wjcyun/Real-time-interactive-platform/Hardware_configuration.pdf

Table. S1 Hardware list

Hardware Module
Item(model) | Image | Parameter | Link
Computer | | Precision 5820 Tower Inter(R) Xeon(R) W-2155 CPU NVIDIA GeForce RTX 2080Ti | https://www.dell.com/zh-cn/shop/ (https://www.dell.com/zh-cn/shop/)

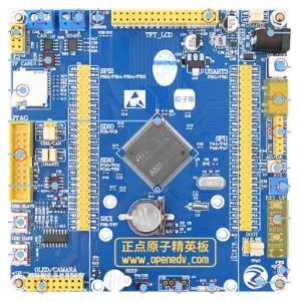
[picture p1: figure]

Stm32 | | STM32F103ZET6 72 MHz clock | https://item.taobao.com/item.htm?spm=a1z 0k.7386009.1997985 097.d4918993.46cf3 7de6uNgrP&id=5230 92580242&_u=t2dm g8j26111
Camera | | HF868SS Pixel Size 3um*3um 480P:120 fps | https://detail.tmall.com/item.htm?_u=t2dmg8j26111&id=627225947424&spm=a1z0 k.7386009.19979850 97.d4918993.46cf37 de6uNgrP

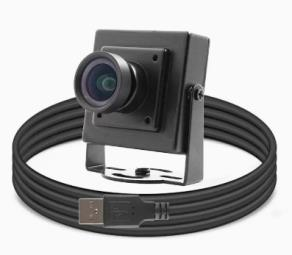
[picture p2: figure]

Servo Motor Driver | | 0.1kw-5.5kw SVPWM 220VAC+10% ~-15% RS-485 | http://www.fereme.cn.tonbao.com/
Slide rail | | Length: 1000 mm Width: 1000 mm | https://item.taobao.com/item.htm?spm=a1z 0k.7386009.1997985 097.d4918993.46cf3 7de6uNgrP&id=6291 15224689&_u=t2dm g8j26111
Square Magnetic Block | | Length: 100 mm Width: 50 mm Thickness: 20 mm | https://item.taobao.com/item.htm?spm=a1z 0k.7386009.1997985 097.d4918993.46cf3 7de6uNgrP&id=5840 42996591&_u=t2dm g8j26111

Round magnetic block | Diameter 40 mm thickness 10 mm | https://detail.tmall.com/item.htm?id=6198 64317122
Regulated power supply | Output voltage: 0-30 V Output current: 0-3 A | https://item.taobao.com/item.htm?spm=a1z 0k.7386009.1997985 097.d4918993.46cf3 7de6uNgrP&id=6104 65415897&_u=t2dm g8j26111

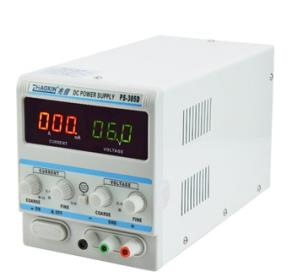
[picture p3: figure]

circuit board | Length: 60 mm Width: 40 mm Hole spacing: 2.54 mm | https://detail.tmall.com/item.htm?abbucket=0&id=619035415749&ns=1&skuId=4368959501684&spm=a 21n57.1.0.0.7237523 chCxvsC
Square acrylic plate | Length: 800 mm Width: 800 mm Thickness：10 mm | https://detail.tmall.com/item.htm?_u=t2dmg8j26111&id=45653259177&spm=a1z0k. 7386009.1997985097 .d4918993.46cf37de6 uNgrP

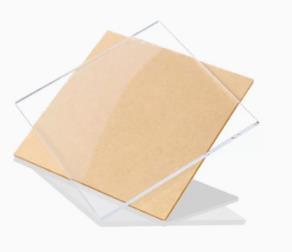
[picture p4: figure]
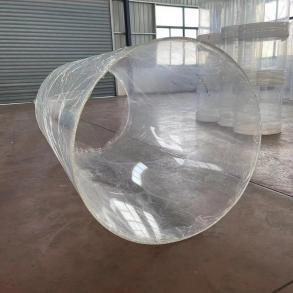
[picture p5: figure]

Acrylic cylinder | Diameter 800 mm, height 300 mm, thickness 8 mm | https://item.taobao.com/item.htm?spm=a1z 0k.7386009.0.0.46cf 37de6uNgrP&id=668 894324208&_u=t2d mg8j26111

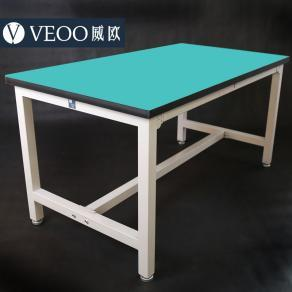
[picture p6: figure]

Anti-vibration table | Length 1500 mm Width 1500 mm Height 750 mm | https://item.taobao.com/item.htm?spm=a1z 0k.7386009.1997985 097.d4918993.46cf3 7de6uNgrP&id=1914 0891812&_u=t2dmg 8j26111

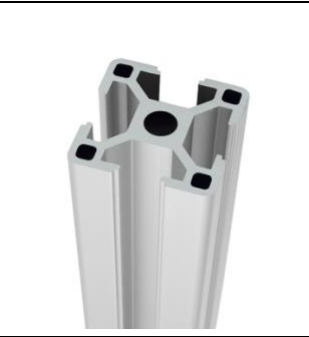
[picture p7: figure]

Platform support frame | OB3030 Length 1600 mm height 900 mm width 800 mm | https://item.taobao.com/item.htm?spm=a1z 0k.7386009.1997985 097.d4918993.46cf3 7de6uNgrP&id=5987 99357725&_u=t2dm g8j26111
Camera support frame | Maximum width 3300 mm, maximum height 2600 mm | https://detail.tmall.com/item.htm?_u=t2dmg8j26111&id=653440514110&spm=a1z0 k.7386009.19979850 97.d4918993.46cf37 de6uNgrP&skuId=47 10466984766

Circuit Components
DuPont Line | / | https://detail.tmall.com/item.htm?ali_refid=a3_430582_1006:11 09983619:N:MsF9m E9KLTC2IibWJh+K 1A==:c2aeb01b6bfca 0fdcd9eb0571b55a20 1&ali_trackid=1_c2a eb01b6bfca0fdcd9eb 0571b55a201&id=41 254478179&spm=a2 1n57.1.0.0&sku_prop erties=122216547:20 213
2N2222A | NPN | https://detail.tmall.com/item.htm?_u=t2dmg8j26111&id=602012446142&spm=a1z0 k.7385961.0.0.3dd33 7deMz7y0R&skuId= 4209941168719

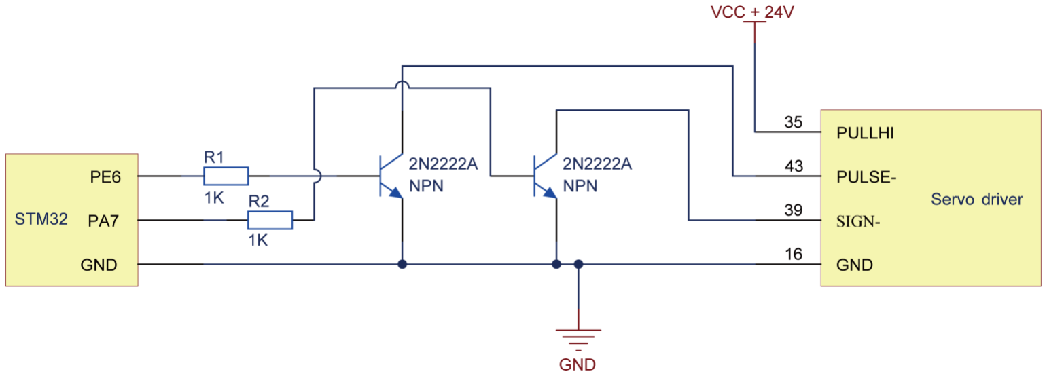
[picture p8: figure]

Fig. S9 Signal adaptation circuit

Ports PE6 and PE7 in the STM32 give direction and speed signal, respectively, which

are passed through an amplifier circuit to ports 43 and 39 of the servo motor

controller.
